hashraf96/Intelligent-Material-Transporting-System/README.md

# Intelligent-Material-Transporting-System
An autonomous material transporting robot whose job is to pick things up and drop them at some specific marked areas has been fabricated and coded.
